RoboticsNetworkTrieste/hoverboard-robot/docs/pictures/lidar_wiring.png

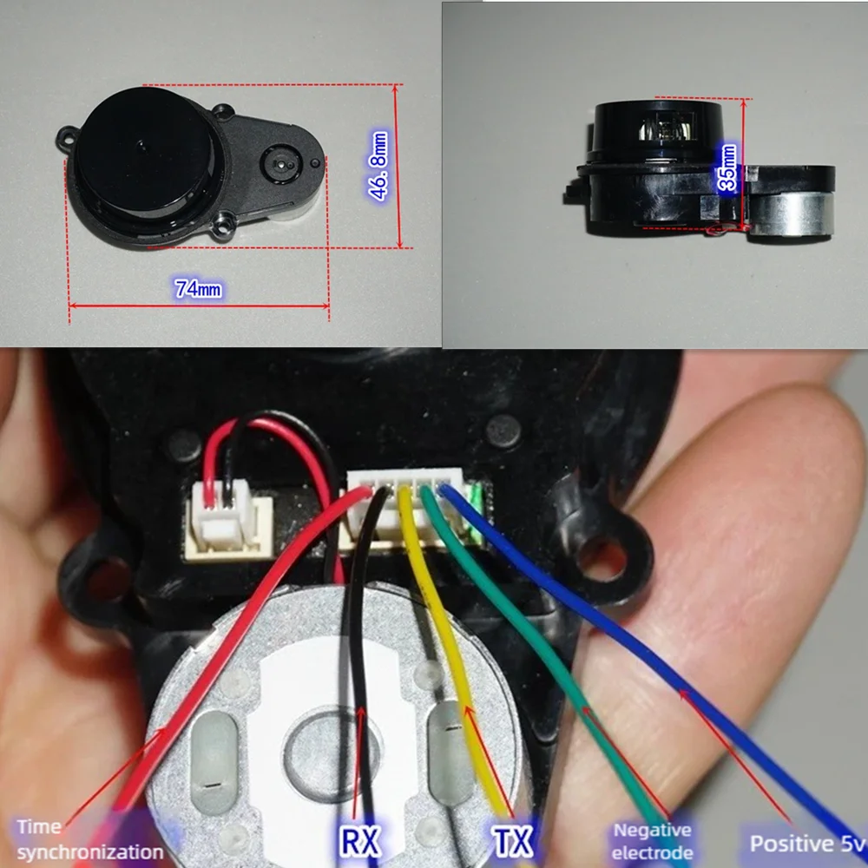
docs/pictures/lidar_wiring.png
