RoboticsNetworkTrieste/hoverboard-robot/docs/pictures/ESP32-S3_pinout.png

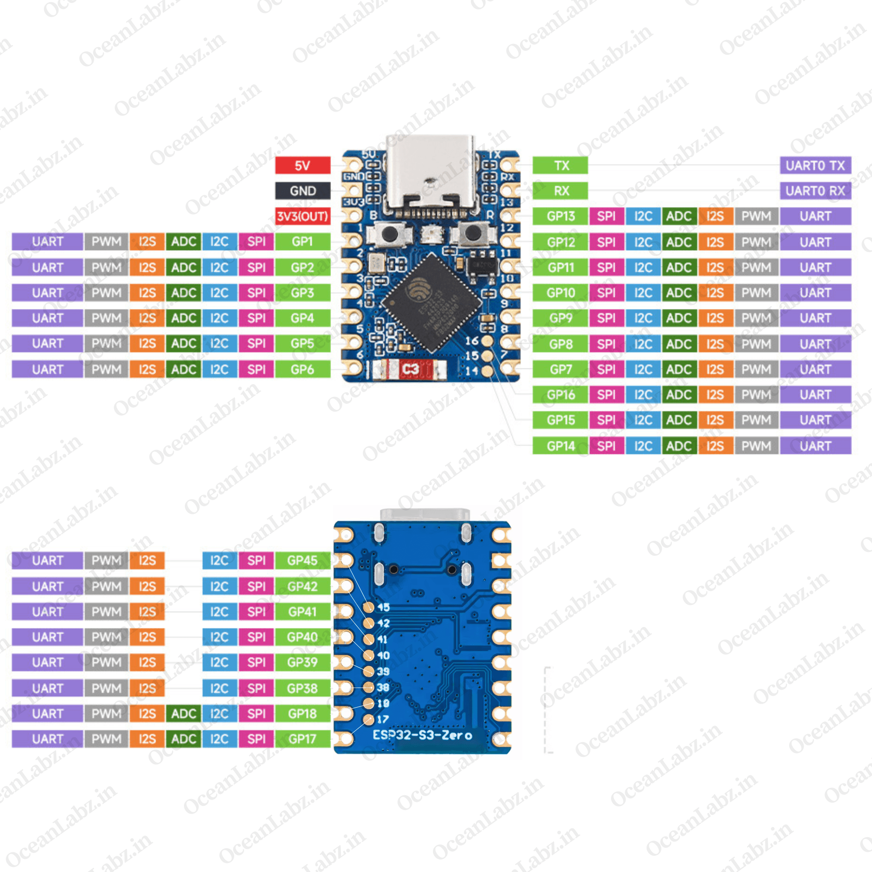
docs/pictures/ESP32-S3_pinout.png
