RoboticsNetworkTrieste/hoverboard-robot/(commit log)

2026-09-13 add: hoverboard_test ESP32 sketch
2026-10-17 feat: esp32 idf project added
2026-10-17 feat: esp32 code WIP
2026-10-18 feat: implement UART-UDP bridge with logging and telemetry features
2026-10-18 update: esp32 README
2026-10-18 update: WIP full assembly test
2026-10-18 feat: add IMU conversion and kinematics calculations with corresponding tests
2026-10-18 feat: implement LidarPty class for LIDAR byte stream handling with tests
2026-10-18 feat: implement hoverboard bridge node with kinematics and tick continuity handling
2026-11-03 feat: ekf filter added
